littlebits/w14-MakeyMakey/hardware/w14_MAKEYMAKEY-v03(2_3)/w14_MAKEYMAKEY-v03(2_3).pdf

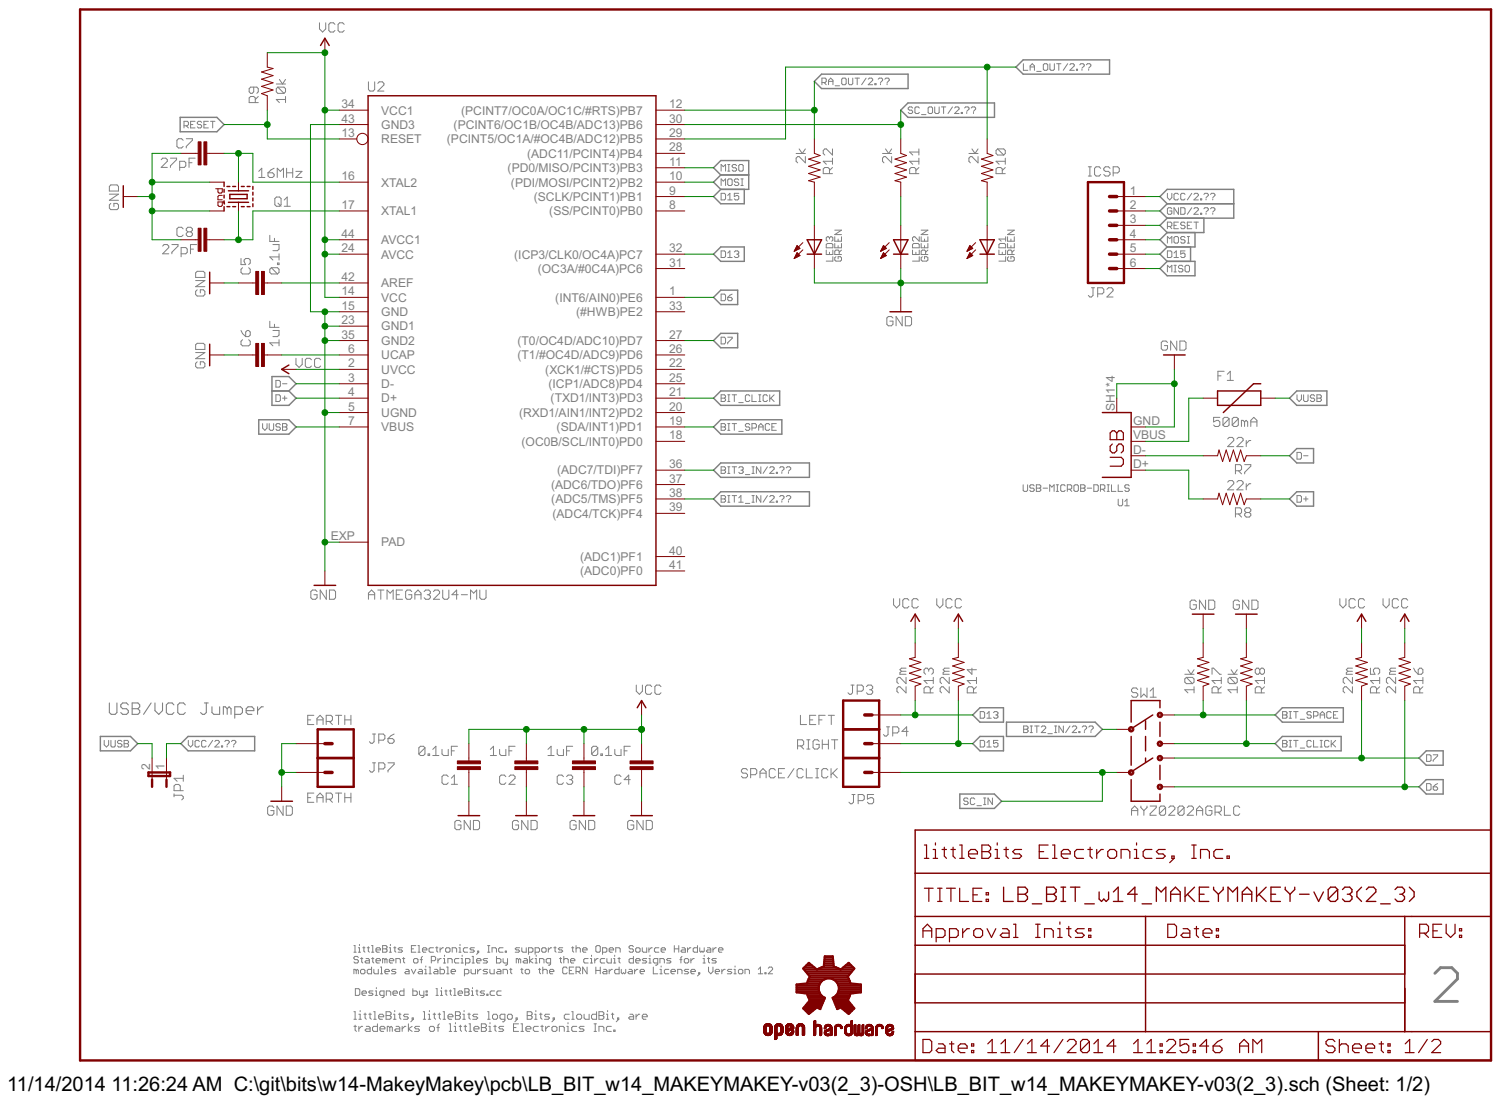
[picture p1: page 1]

11/14/2014 11:26:24 AM C:\git\bits\w14-MakeyMakey\pcb\LB_BIT_w14_MAKEYMAKEY-v03(2_3)-OSH\LB_BIT_w14_MAKEYMAKEY-v03(2_3).sch (Sheet: 1/2)

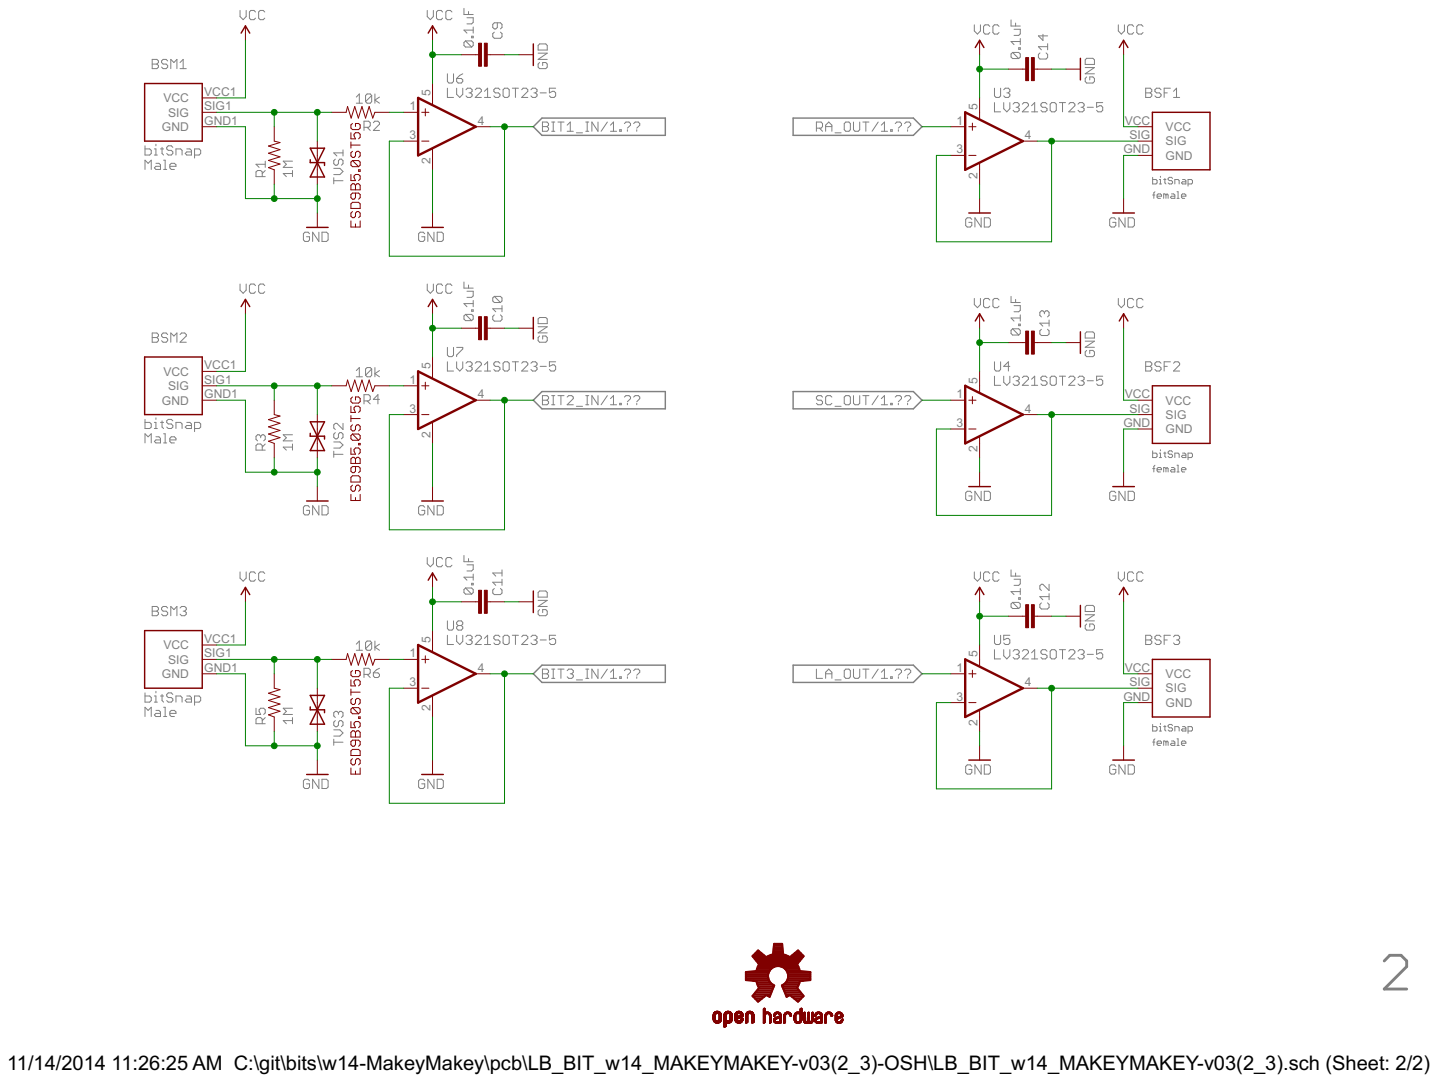
[picture p2: page 2]

11/14/2014 11:26:25 AM C:\git\bits\w14-MakeyMakey\pcb\LB_BIT_w14_MAKEYMAKEY-v03(2_3)-OSH\LB_BIT_w14_MAKEYMAKEY-v03(2_3).sch (Sheet: 2/2)
