littlebits/w14-MakeyMakey/hardware/w14_MAKEYMAKEY-v03(2_3)/w14_MAKEYMAKEY-v03(2_3).brd

## EAGLE design hardware/w14_MAKEYMAKEY-v03(2_3)/w14_MAKEYMAKEY-v03(2_3).brd (2015-04-21)

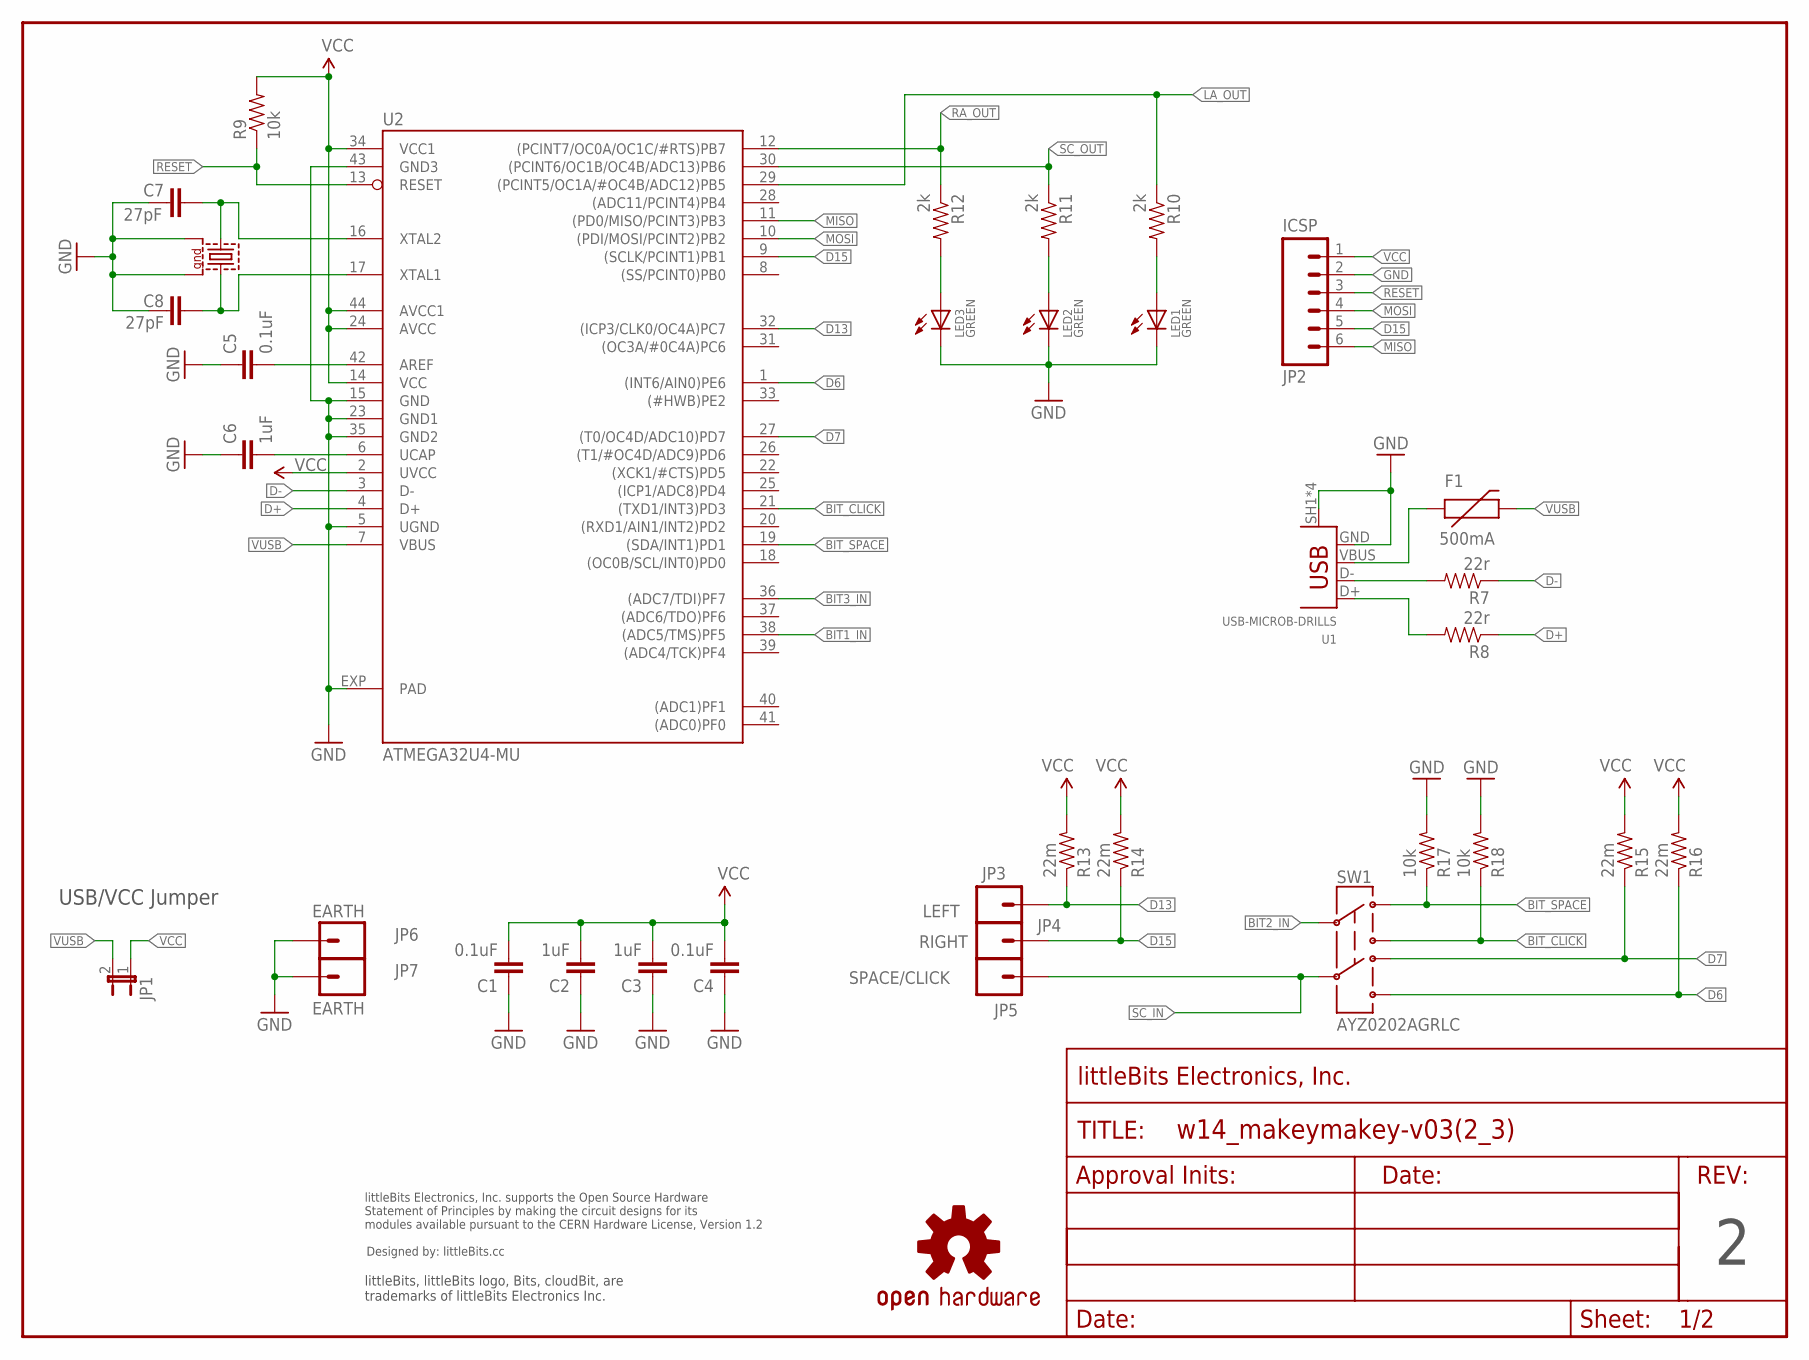
[picture p3: schematic w14_MAKEYMAKEY-v03(2_3).sch, sheet 1, i/o filters]

Parts:
C1, C4, C5: 0.1uF; CAP-0603
C2, C3, C6: 1uF; CAP-0603
C7, C8: 27pF; CAP-0603
F1: 500mA; PTC-1206
JP1: JUMPER-2SMD-NO; SJ_2S-NO
JP2: ICSP; SIP6-SM-0.1IN-NOS.S.
JP3: LEFT; 1X01_ALLIGATOR_3MM
JP4: RIGHT; 1X01_ALLIGATOR_3MM
JP5: SPACE/CLICK; 1X01_ALLIGATOR_3MM
JP6, JP7: EARTH; 1X01_ALLIGATOR_3MM
LED1, LED2, LED3: GREEN; LED-1206
Q1: 16MHz; CRYSTAL-SMD-7B-SERIES-5X3.2MM
R7, R8: 22r; RES-0603
R9, R17, R18: 10k; RES-0603
R10, R11, R12: 2k; RES-0603
R13, R14, R15, R16: 22m; RES-0603
SW1: AYZ0202AGRLC; AYZ0202
U1: USB-MICROB-DRILLS; USB-MICROB-AUK-DRILLS
U2: ATMEGA32U4-MU; QFN44ML7X7
U$1: OSHWCREDIT
U$58: FRAME-LETTER-OHWOHW; FABDWG01-OHW
U$70: OSHW-LOGOL; OSHW-LOGO-L

Connections:
BIT1_IN: U2.38 ((ADC5/TMS)PF5); also elsewhere on the board
BIT2_IN: SW1.2; also elsewhere on the board
BIT3_IN: U2.36 ((ADC7/TDI)PF7); also elsewhere on the board
BIT_CLICK: R18.1, SW1.3, U2.21 ((TXD1/INT3)PD3)
BIT_SPACE: R17.1, SW1.1, U2.19 ((SDA/INT1)PD1)
D6: R16.1, SW1.6, U2.1 ((INT6/AIN0)PE6)
D7: R15.1, SW1.4, U2.27 ((T0/OC4D/ADC10)PD7)
D13: JP3.1@0, JP3.1@2, R13.1, U2.32 ((ICP3/CLK0/OC4A)PC7)
D15: JP2.5, JP4.1@0, JP4.1@2, R14.1, U2.9 ((SCLK/PCINT1)PB1)
D+: R8.1, U2.4 (D+)
D-: R7.1, U2.3 (D-)
GND: C1.1, C2.1, C3.2, C4.1, C5.1, C6.1, C7.2, C8.2, JP2.2, JP6.1@0, JP6.1@2, JP7.1@0, JP7.1@2, LED1.C, LED2.C, LED3.C, Q1.P$2 (2), Q1.P$4 (4), R17.2, R18.2, U1.GND, U1.SH1 (SH), U1.SH2 (SH), U1.SH3 (SH), U1.SH4 (SH), U2.5 (UGND), U2.15 (GND), U2.23 (GND1), U2.35 (GND2), U2.43 (GND3), U2.EXP (PAD); also elsewhere on the board
LA_OUT: R10.1, U2.29 ((PCINT5/OC1A/#OC4B/ADC12)PB5); also elsewhere on the board
MISO: JP2.6, U2.11 ((PD0/MISO/PCINT3)PB3)
MOSI: JP2.4, U2.10 ((PDI/MOSI/PCINT2)PB2)
unnamed: LED3.A, R12.2
unnamed: LED1.A, R10.2
unnamed: LED2.A, R11.2
unnamed: C5.2, U2.42 (AREF)
unnamed: C7.1, Q1.P$3 (3), U2.16 (XTAL2)
unnamed: R7.2, U1.D-
unnamed: R8.2, U1.D+
unnamed: F1.1, U1.VBUS
unnamed: C8.1, Q1.P$1 (1), U2.17 (XTAL1)
unnamed: C6.2, U2.6 (UCAP)
RA_OUT: R12.1, U2.12 ((PCINT7/OC0A/OC1C/#RTS)PB7); also elsewhere on the board
RESET: JP2.3, R9.1, U2.13 (RESET)
SC_IN: JP5.1@0, JP5.1@2, SW1.5
SC_OUT: R11.1, U2.30 ((PCINT6/OC1B/OC4B/ADC13)PB6); also elsewhere on the board
VCC: C1.2, C2.2, C3.1, C4.2, JP1.1, JP2.1, R9.2, R13.2, R14.2, R15.2, R16.2, U2.2 (UVCC), U2.14 (VCC), U2.24 (AVCC), U2.34 (VCC1), U2.44 (AVCC1); also elsewhere on the board
VUSB: F1.2, JP1.2, U2.7 (VBUS)

Notes on the sheet:
USB/VCC Jumper

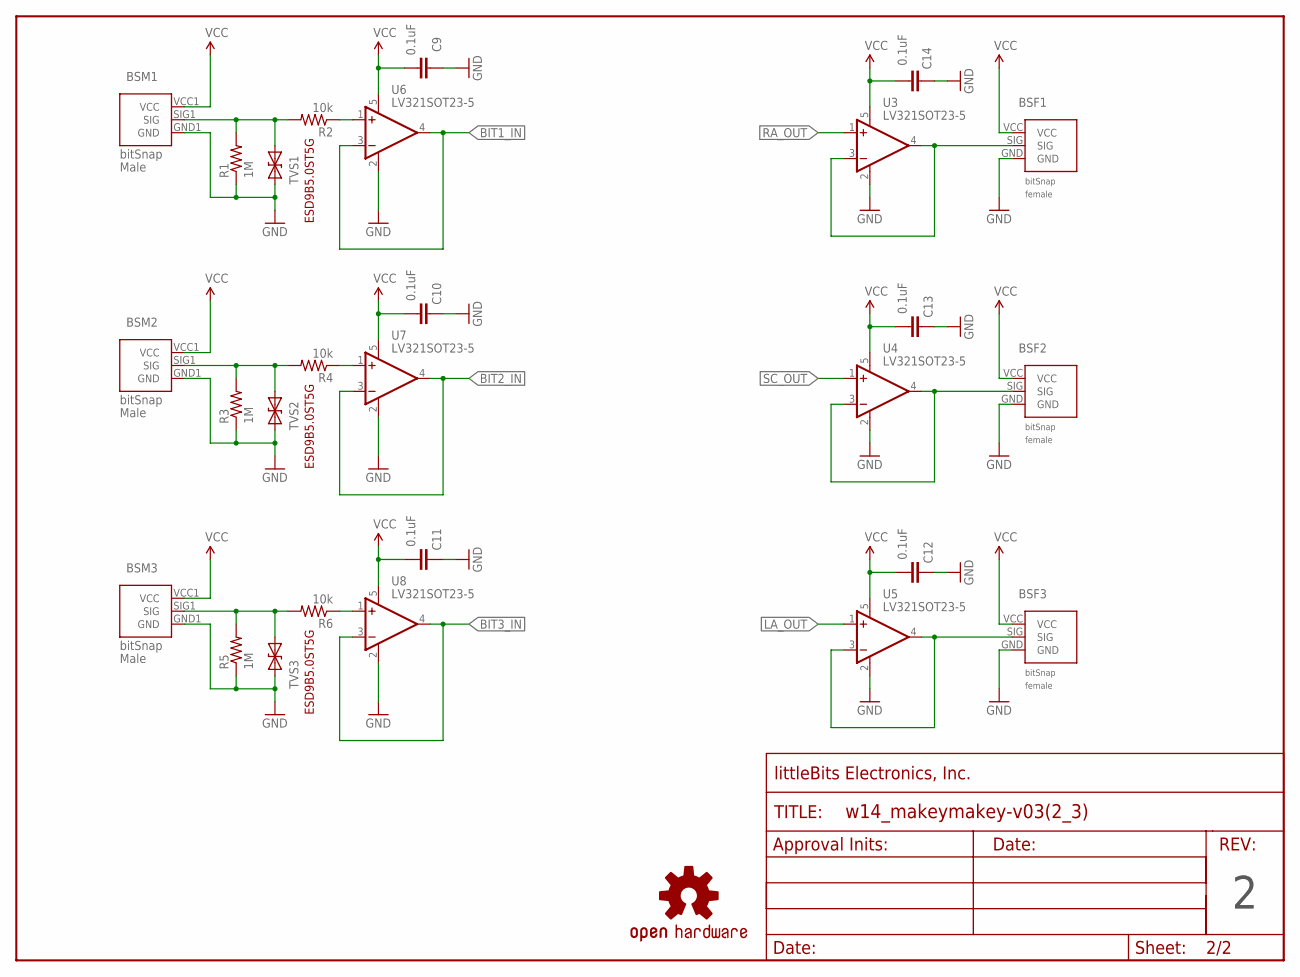
[picture p4: schematic w14_MAKEYMAKEY-v03(2_3).sch, sheet 2]

Parts:
BSF1, BSF2, BSF3: BITSNAP_V03_FEMALE
BSM1, BSM2, BSM3: BITSNAP_V03_MALE
C9, C10, C11, C12, C13, C14: 0.1uF; CAP-0603
R1, R3, R5: 1M; RES-0603
R2, R4, R6: 10k; RES-0603
TVS1, TVS2, TVS3: ESD9B5.0ST5G; SOD-923
U3, U4, U5, U6, U7, U8: LV321SOT23-5; SOT23-5
U$2: FRAME-LETTER-OHWOHW; FABDWG01-OHW
U$56: OSHW-LOGOL; OSHW-LOGO-L

Connections:
BIT1_IN: U6.3 (-IN), U6.4 (OUT); also elsewhere on the board
BIT2_IN: U7.3 (-IN), U7.4 (OUT); also elsewhere on the board
BIT3_IN: U8.3 (-IN), U8.4 (OUT); also elsewhere on the board
GND: BSF1.GND, BSF2.GND, BSF3.GND, BSM1.GND1 (GND), BSM2.GND1 (GND), BSM3.GND1 (GND), C9.1, C10.1, C11.1, C12.1, C13.1, C14.1, R1.1, R3.1, R5.1, TVS1.1 (A), TVS2.1 (A), TVS3.1 (A), U3.2 (V-), U4.2 (V-), U5.2 (V-), U6.2 (V-), U7.2 (V-), U8.2 (V-); also elsewhere on the board
LA_OUT: U5.1 (+IN); also elsewhere on the board
unnamed: R4.1, U7.1 (+IN)
unnamed: R2.1, U6.1 (+IN)
unnamed: R6.1, U8.1 (+IN)
RA_OUT: U3.1 (+IN); also elsewhere on the board
SC_OUT: U4.1 (+IN); also elsewhere on the board
SIG1_IN: BSM1.SIG1 (SIG), R1.2, R2.2, TVS1.2 (C)
SIG1_OUT: BSF1.SIG, U3.3 (-IN), U3.4 (OUT)
SIG2_IN: BSM2.SIG1 (SIG), R3.2, R4.2, TVS2.2 (C)
SIG2_OUT: BSF2.SIG, U4.3 (-IN), U4.4 (OUT)
SIG3_IN: BSM3.SIG1 (SIG), R5.2, R6.2, TVS3.2 (C)
SIG3_OUT: BSF3.SIG, U5.3 (-IN), U5.4 (OUT)
VCC: BSF1.VCC, BSF2.VCC, BSF3.VCC, BSM1.VCC1 (VCC), BSM2.VCC1 (VCC), BSM3.VCC1 (VCC), C9.2, C10.2, C11.2, C12.2, C13.2, C14.2, U3.5 (V+), U4.5 (V+), U5.5 (V+), U6.5 (V+), U7.5 (V+), U8.5 (V+); also elsewhere on the board

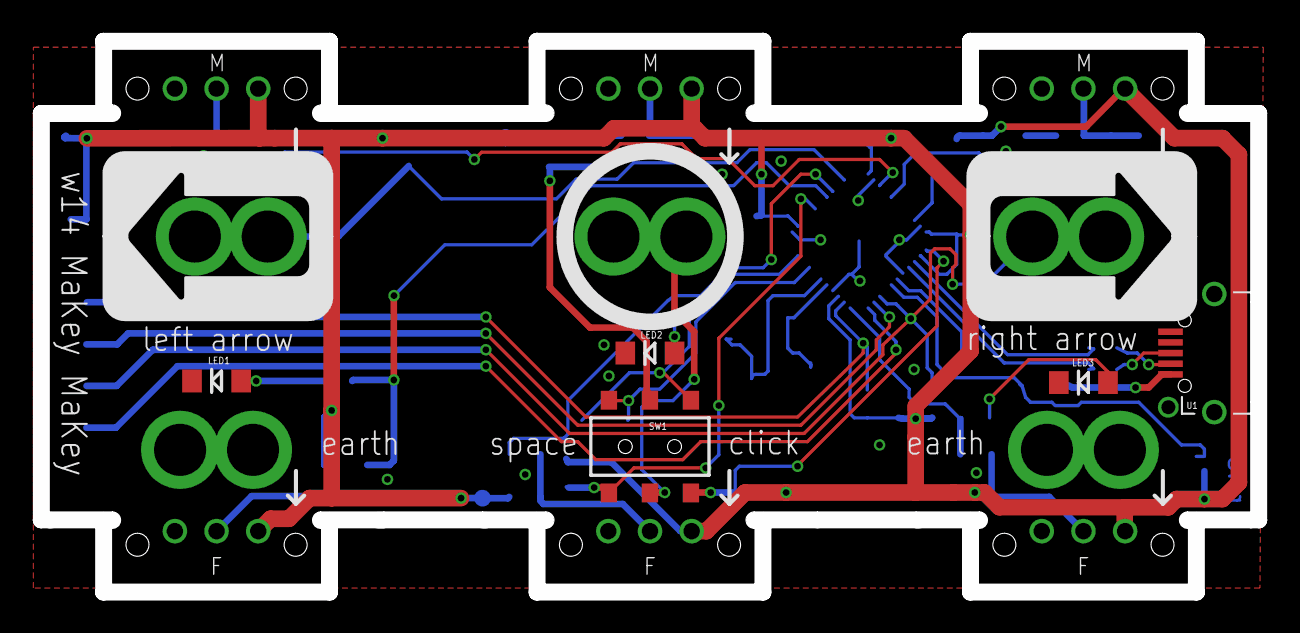
[picture p5: board w14_MAKEYMAKEY-v03(2_3).brd from above]

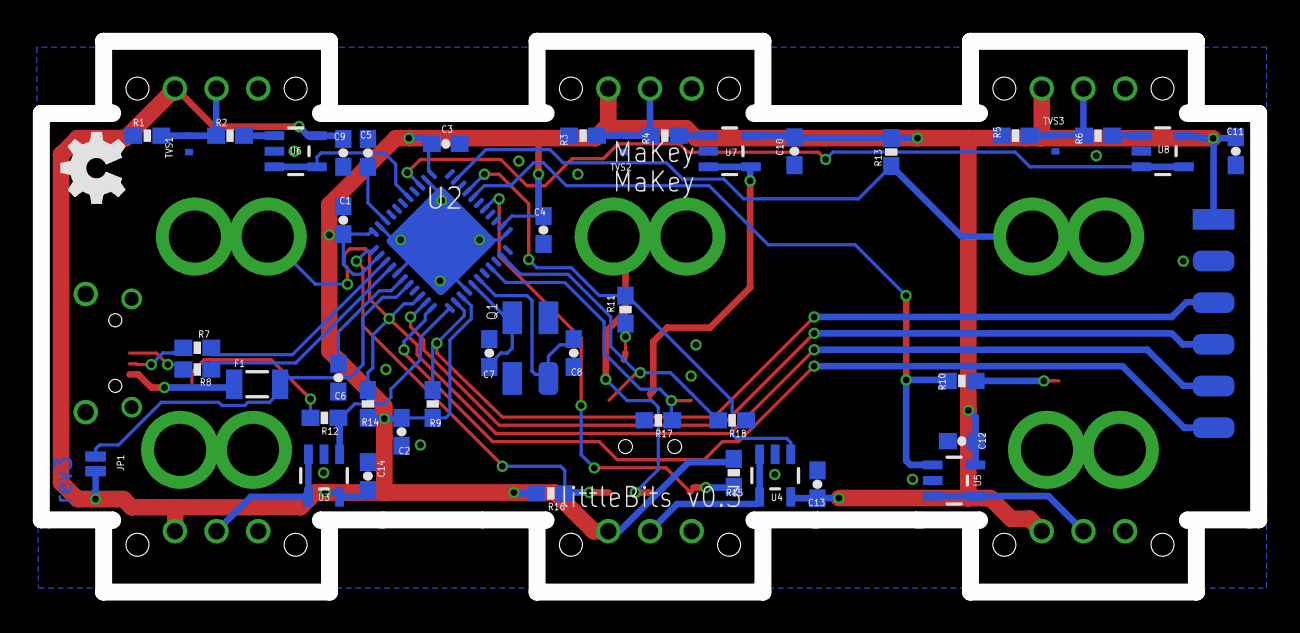
[picture p6: board w14_MAKEYMAKEY-v03(2_3).brd from below]

Board: 2 copper layers, 73.2 x 32.6 mm, 68 parts (46 on the bottom side), 40 nets.

Other parts of the board:
U$5: OSHW_FILLX150_NOTEXT
