littlebits/w14-MakeyMakey/(threads)

Thread 1 (2023-05-18):

Settings.h file will not compile on Arduino IDE

the4bitCoder, 2023-05-18:
I tried to compile settings.h file on Arduino IDE ,but it wasn't working.
The problem seemed to be with the:
```#include "Arduino.h" ```
Which when I replaced with:
```#include <Keyboard.h>```
```#include <Mouse.h>```
It compiled an worked fine.
