littlebits/w14-MakeyMakey/firmware/makey_makey_LB_bit/makey_makey_LB_bit.ino

/*
 ************************************************
 ************** MAKEY MAKEY *********************
 ************************************************
 
 /////////////////////////////////////////////////
 /////////////HOW TO EDIT THE KEYS ///////////////
 /////////////////////////////////////////////////
 - Edit keys in the settings.h file
 - that file should be open in a tab above (in Arduino IDE)
 - more instructions are in that file
 
 //////////////////////////////////////////////////
 ///////////  littleBits MaKey MaKey  /////////////
 /////////////  FIRMWARE v140923a  ////////////////
 ///////////////////// for ////////////////////////
 //////////////// HARDWARE v2_3 ///////////////////
 //////////////////////////////////////////////////
 Based on MaKey MaKey FIRMWARE v1.4.1
 by: Eric Rosenbaum, Jay Silver, and Jim Lindblom
 MIT Media Lab & Sparkfun
 start date: 2/16/2012 
 current release: 7/5/2012
 
 modified by: littleBits Electronics
 date modified: 10/10/2014
 */

/////////////////////////
// DEBUG DEFINITIONS ////               
/////////////////////////
//#define DEBUG
//#define DEBUG2 
//#define DEBUG3 
//#define DEBUG_TIMING
//#define DEBUG_MOUSE
//#define DEBUG_TIMING2

////////////////////////
// DEFINED CONSTANTS////
////////////////////////

#define BUFFER_LENGTH    3     // 3 bytes gives us 24 samples
#define NUM_INPUTS       8     // 4 on the top, 4 from the bitsnaps
//#define TARGET_LOOP_TIME 694   // (1/60 seconds) / 24 samples = 694 microseconds per sample 
//#define TARGET_LOOP_TIME 758  // (1/55 seconds) / 24 samples = 758 microseconds per sample 
#define TARGET_LOOP_TIME 744  // (1/56 seconds) / 24 samples = 744 microseconds per sample

// modified by littleBits
// Sets maximum time an input bitsnap will trigger from a logic-high signal
// Prevents power bits from constantly triggering keyboard events
#define MAX_BIT_INPUT_HOLD 100

// id numbers for mouse movement inputs (used in settings.h)
//#define MOUSE_MOVE_UP       -1 
//#define MOUSE_MOVE_DOWN     -2
//#define MOUSE_MOVE_LEFT     -3
//#define MOUSE_MOVE_RIGHT    -4

#include "settings.h"

/////////////////////////
// STRUCT ///////////////
/////////////////////////
typedef struct {
  byte pinNumber;
  int keyCode;
  byte measurementBuffer[BUFFER_LENGTH]; 
  boolean oldestMeasurement;
  byte bufferSum;
  boolean pressed;
  boolean prevPressed;
  boolean isMouseMotion;
  boolean isMouseButton;
  boolean isKey;
  
  // modified by littleBits 
  // variables to track input bitsnap trigger time
  unsigned long startPress;
  unsigned long holdTime;
} 
MakeyMakeyInput;

MakeyMakeyInput inputs[NUM_INPUTS];

///////////////////////////////////
// VARIABLES //////////////////////
///////////////////////////////////
int bufferIndex = 0;
byte byteCounter = 0;
byte bitCounter = 0;
int mouseMovementCounter = 0; // for sending mouse movement events at a slower interval

int pressThreshold;
int releaseThreshold;
boolean inputChanged;

int mouseHoldCount[NUM_INPUTS]; // used to store mouse movement hold data

// Pin Numbers

// modified by littleBits
// Input pins 0-3: surface pads
// Input pins 4-7: input bitsnaps
int pinNumbers[NUM_INPUTS] = {
  13, 15, 6, 7, A0, A2, 2, 1
  };

// input status LED pin numbers
const int inputLED_a = 9;
const int inputLED_c = 10;
const int inputLED_b = 11;


// timing
int loopTime = 0;
int prevTime = 0;
int loopCounter = 0;


///////////////////////////
// FUNCTIONS //////////////
///////////////////////////
void initializeArduino();
void initializeInputs();
void updateMeasurementBuffers();
void updateBufferSums();
void updateBufferIndex();
void updateInputStates();
void sendMouseButtonEvents();
void addDelay();
void cycleLEDs();



//////////////////////
// SETUP /////////////
//////////////////////
void setup() 
{
  initializeArduino();
  initializeInputs();
}

////////////////////
// MAIN LOOP ///////
////////////////////
void loop() 
{
  updateMeasurementBuffers();
  updateBufferSums();
  updateBufferIndex();
  updateInputStates();
  sendMouseButtonEvents();
  cycleLEDs();

  addDelay();
}

//////////////////////////
// INITIALIZE ARDUINO
//////////////////////////
void initializeArduino() {
#ifdef DEBUG
  Serial.begin(9600);  // Serial for debugging
#endif

  /* Set up input pins 
   DEactivate the internal pull-ups, since we're using external resistors */
  for (int i=0; i<NUM_INPUTS; i++)
  {
    pinMode(pinNumbers[i], INPUT);
    digitalWrite(pinNumbers[i], LOW);
  }

  pinMode(inputLED_a, OUTPUT); 
  pinMode(inputLED_b, OUTPUT);
  pinMode(inputLED_c, OUTPUT);
  digitalWrite(inputLED_a, LOW);
  digitalWrite(inputLED_b, LOW);
  digitalWrite(inputLED_c, LOW);

#ifdef DEBUG
  delay(4000); // allow us time to reprogram in case things are freaking out
#endif

  Keyboard.begin();
  Mouse.begin();
}

///////////////////////////
// INITIALIZE INPUTS
///////////////////////////
void initializeInputs() {

  float thresholdPerc = SWITCH_THRESHOLD_OFFSET_PERC;
  float thresholdCenterBias = SWITCH_THRESHOLD_CENTER_BIAS/50.0;
  float pressThresholdAmount = (BUFFER_LENGTH * 8) * (thresholdPerc / 100.0);
  float thresholdCenter = ( (BUFFER_LENGTH * 8) / 2.0 ) * (thresholdCenterBias);
  pressThreshold = int(thresholdCenter + pressThresholdAmount);
  releaseThreshold = int(thresholdCenter - pressThresholdAmount);

#ifdef DEBUG
  Serial.println(pressThreshold);
  Serial.println(releaseThreshold);
#endif

  for (int i=0; i<NUM_INPUTS; i++) {
    inputs[i].pinNumber = pinNumbers[i];
    inputs[i].keyCode = keyCodes[i];
    
    // Added by littleBits
    // initialize timing vars for tracking input bitsnap activation 
    inputs[i].startPress = 0;
    inputs[i].holdTime = 0;

    for (int j=0; j<BUFFER_LENGTH; j++) {
      inputs[i].measurementBuffer[j] = 0;
    }
    inputs[i].oldestMeasurement = 0;
    inputs[i].bufferSum = 0;

    inputs[i].pressed = false;
    inputs[i].prevPressed = false;

    inputs[i].isMouseMotion = false;
    inputs[i].isMouseButton = false;
    inputs[i].isKey = false;

    if (inputs[i].keyCode < 0) {
#ifdef DEBUG_MOUSE
      Serial.println("GOT IT");  
#endif

      inputs[i].isMouseMotion = true;
    } 
    else if ((inputs[i].keyCode == MOUSE_LEFT) || (inputs[i].keyCode == MOUSE_RIGHT)) {
      inputs[i].isMouseButton = true;
    } 
    else {
      inputs[i].isKey = true;
    }
#ifdef DEBUG
    Serial.println(i);
#endif

  }
}


//////////////////////////////
// UPDATE MEASUREMENT BUFFERS
//////////////////////////////
void updateMeasurementBuffers() {

  for (int i=0; i<NUM_INPUTS; i++) {

    // store the oldest measurement, which is the one at the current index,
    // before we update it to the new one 
    // we use oldest measurement in updateBufferSums
    byte currentByte = inputs[i].measurementBuffer[byteCounter];
    inputs[i].oldestMeasurement = (currentByte >> bitCounter) & 0x01; 

    // make the new measurement
    boolean newMeasurement = digitalRead(inputs[i].pinNumber);

    // modified by littleBits
    // invert so that true means the switch is closed
    // if input is 0-3, it is a surface pad, and needs to be inverted
    // if input is 4-7, it is an input bitSnap, and the polarity is okay
    if(i<4)
    {newMeasurement = !newMeasurement;} 
    else
      {newMeasurement = newMeasurement;}
    // store it    
    if (newMeasurement) {
      currentByte |= (1<<bitCounter);
    } 
    else {
      currentByte &= ~(1<<bitCounter);
    }
    inputs[i].measurementBuffer[byteCounter] = currentByte;
  }
}

///////////////////////////
// UPDATE BUFFER SUMS
///////////////////////////
void updateBufferSums() {

  // the bufferSum is a running tally of the entire measurementBuffer
  // add the new measurement and subtract the old one

  for (int i=0; i<NUM_INPUTS; i++) {
    byte currentByte = inputs[i].measurementBuffer[byteCounter];
    boolean currentMeasurement = (currentByte >> bitCounter) & 0x01; 
    if (currentMeasurement) {
      inputs[i].bufferSum++;
    }
    if (inputs[i].oldestMeasurement) {
      inputs[i].bufferSum--;
    }
  }  
}

///////////////////////////
// UPDATE BUFFER INDEX
///////////////////////////
void updateBufferIndex() {
  bitCounter++;
  if (bitCounter == 8) {
    bitCounter = 0;
    byteCounter++;
    if (byteCounter == BUFFER_LENGTH) {
      byteCounter = 0;
    }
  }
}

///////////////////////////
// UPDATE INPUT STATES
///////////////////////////
void updateInputStates() {
  inputChanged = false;
  for (int i=0; i<NUM_INPUTS; i++) {
    inputs[i].prevPressed = inputs[i].pressed; // store previous pressed state (only used for mouse buttons)
    
    if (inputs[i].pressed) {
      // modified by littleBits
      // Added condition to set output low if input bitSnap is held high too long
      if (inputs[i].bufferSum < releaseThreshold || inputs[i].holdTime >= MAX_BIT_INPUT_HOLD) {  
        inputChanged = true;
        inputs[i].pressed = false;
        if (inputs[i].isKey) {
          Keyboard.release(inputs[i].keyCode);
        }
        if (inputs[i].isMouseMotion) {  
          mouseHoldCount[i] = 0;  // input becomes released, reset mouse hold
        }
      }
      else if (inputs[i].isMouseMotion) {  
        mouseHoldCount[i]++; // input remains pressed, increment mouse hold
      }
    } 
    else if (!inputs[i].pressed) {
      // modified by littleBits
      // if a bitsnap is triggered, start counting the length of time the bitsnap is triggered
      if (inputs[i].bufferSum > pressThreshold && inputs[i].holdTime < MAX_BIT_INPUT_HOLD) {  // input becomes pressed
        inputChanged = true;
        inputs[i].pressed = true; 
        inputs[i].startPress = millis();
        inputs[i].holdTime = 0;
        if (inputs[i].isKey) {
          Keyboard.press(inputs[i].keyCode);
        }
      }
    }
    
    // modified by littleBits
    // if the input bitSnap is logic-high, keep track of time input is high
    if (inputs[i].bufferSum > pressThreshold && i>=4) {
      inputs[i].holdTime = millis() - inputs[i].startPress;
    }
    
    // modified by littleBits
    // if the input bitSnap is logic-low, reset time tracking
    if (inputs[i].bufferSum < releaseThreshold && i>=4) {
      inputs[i].holdTime = 0;
      inputs[i].startPress = 0;
    }
      
  }
#ifdef DEBUG3
  if (inputChanged) {
    Serial.println("change");
  }
#endif
}


/////////////////////////////
// SEND MOUSE BUTTON EVENTS 
/////////////////////////////
void sendMouseButtonEvents() {
  if (inputChanged) {
    for (int i=0; i<NUM_INPUTS; i++) {
      if (inputs[i].isMouseButton) {
        if (inputs[i].pressed) {
          if (inputs[i].keyCode == MOUSE_LEFT) {
            Mouse.press(MOUSE_LEFT);
          } 
          if (inputs[i].keyCode == MOUSE_RIGHT) {
            Mouse.press(MOUSE_RIGHT);
          } 
        } 
        else if (inputs[i].prevPressed) {
          if (inputs[i].keyCode == MOUSE_LEFT) {
            Mouse.release(MOUSE_LEFT);
          } 
          if (inputs[i].keyCode == MOUSE_RIGHT) {
            Mouse.release(MOUSE_RIGHT);
          }           
        }
      }
    }
  }
}

///////////////////////////
// ADD DELAY
///////////////////////////
void addDelay() {

  loopTime = micros() - prevTime;
  if (loopTime < TARGET_LOOP_TIME) {
    int wait = TARGET_LOOP_TIME - loopTime;
    delayMicroseconds(wait);
  }

  prevTime = micros();

#ifdef DEBUG_TIMING
  if (loopCounter == 0) {
    int t = micros()-prevTime;
    Serial.println(t);
  }
  loopCounter++;
  loopCounter %= 999;
#endif

}

///////////////////////////
// CYCLE LEDS
///////////////////////////
void cycleLEDs() {
  pinMode(inputLED_a, OUTPUT);
  pinMode(inputLED_b, OUTPUT);
  pinMode(inputLED_c, OUTPUT);
  
  // modified by littleBits
  // changed LED output from original PWM behavior to a constant-high or low output
  // LED states are dependent on both input bitSnaps and suface pads
  if ((inputs[0].pressed || inputs[4].pressed)) {
    pinMode(inputLED_a, OUTPUT);
    digitalWrite(inputLED_a, HIGH);
  } else {
    digitalWrite(inputLED_a, LOW);
  }
  if ((inputs[1].pressed || inputs[5].pressed)) {
    pinMode(inputLED_b, OUTPUT);
    digitalWrite(inputLED_b,HIGH);
  } else {
    digitalWrite(inputLED_b, LOW);
  }
  if (( inputs[2].pressed || inputs[6].pressed || inputs[3].pressed || inputs[7].pressed )) {
    pinMode(inputLED_c, OUTPUT);
    digitalWrite(inputLED_c,HIGH);
  } else {
    digitalWrite(inputLED_c, LOW);
  }
}
