littlebits/w14-MakeyMakey/(notices)

Notices in the files:
parts and their libraries:
LITTLEBITS: modules available pursuant to the CERN Hardware License,
Version 1.2
SparkFun-Connectors: Licensing: CC v3.0 Share-Alike You are welcome to use this library for commercial purposes.
LITTLEBITS: modules available pursuant to the CERN Hardware License, Version 1.2
